lilinguyen015-sys/Capstone-Spring-2026/Documentation/ECE4773_CDR_Self_Driving_Car.pdf

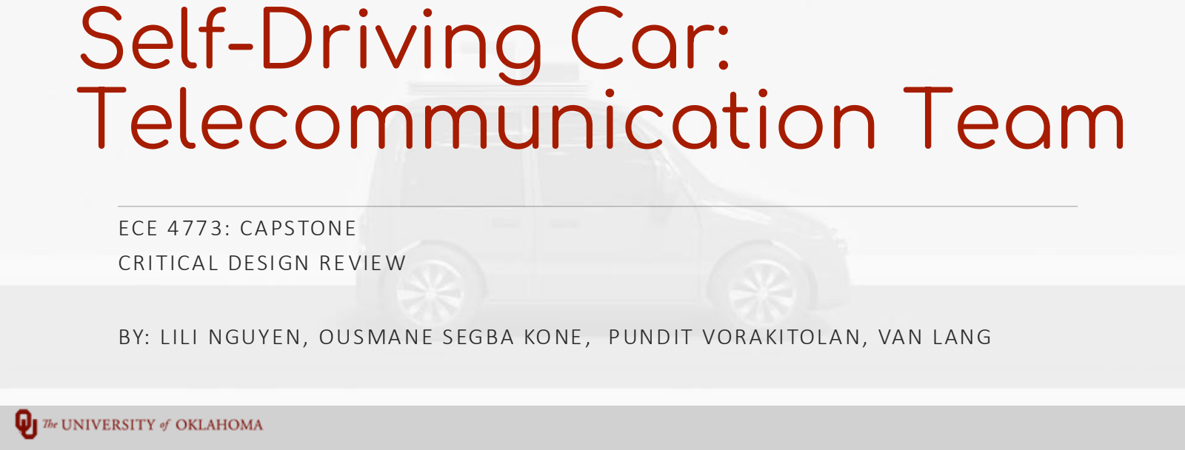
[picture p2: page 1]

# Self-Driving Car: Telecommunication Team

ECE 4 77 3: CA PS TONE
CRI TICA L DESI GN RE VIE W

BY: LILI NGUYEN, OUS MA NE S EGBA KO NE , P UND IT VORA KI TOLA N, VA N LANG

# The Problem/Requirements

- Current State:
- The 2025 Nissan Leaf is controllable via PS5 gamepad, but limited by Bluetooth range (<30 ft)
- The Challenge:
- Maintaining low-latency (≤ 100ms) over long distance networks

▪Should ensure vehicle safety if the connection drops

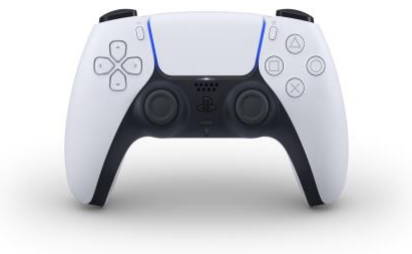
[picture p3: figure]
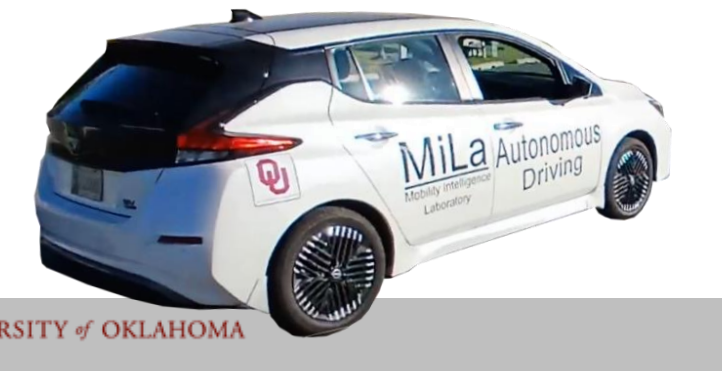
[picture p4: figure]

LN

# Design Objective

### - Read Logitech G29 input

### - Normalize steering and pedal data

### - Send commands over the communication link

### - Process commands on the ESP32Output vehicle control signals

### - Include safety and failsafe logic

LN

## Top Level Block Diagram

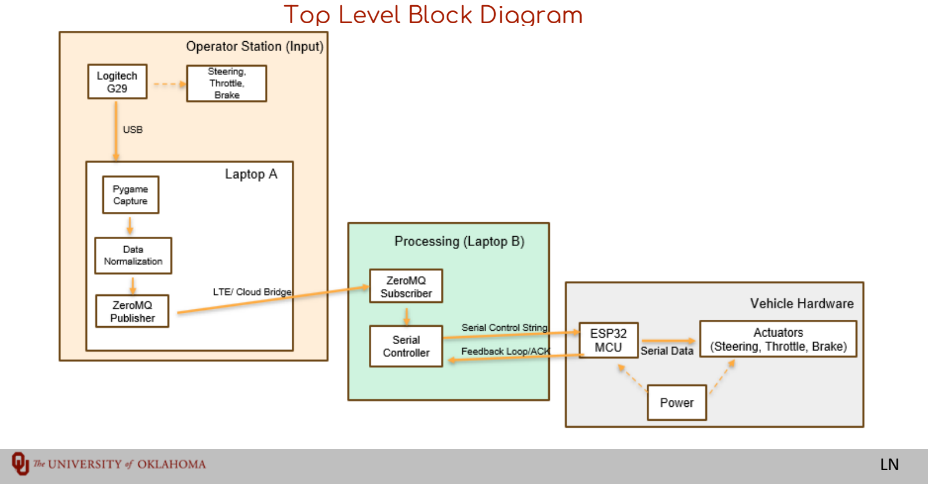
[picture p5: page 4]

LN

# Schedule/Milestones

Phase | Key Tasks | Status | Milestone / Deliverable
1. Research | Bench-test G29, Pivot to ZeroMQ | Complete | Preliminary Design
2. Development | Two-Laptop Relay Setup | Complete | Functional Communication Link
3. Integration | Bridging LTE/Cloud to the Nissan Leaf | End of March | Long-Range Connectivity Test
4. Validation | Connection Loss Drills | Early April | Safety Validation
5. Operations | Performance Audit & Final Demo | End of April | Successful Parking Lot Demo

LN

# Hardware / Software Components

OSK

### HARDWARE

- Logitech G29
- Sender Laptop
- Receiver Laptop
- ESP32
- Network Link

### SOFTWARE

- Python
- Pygame
- ZeroMQ
- JSON
- Time module

### ROLES

- Sender → Read
inputs, send events
- Receiver → Receive
events, compute
latency

# Communication / Control Flow

OSK

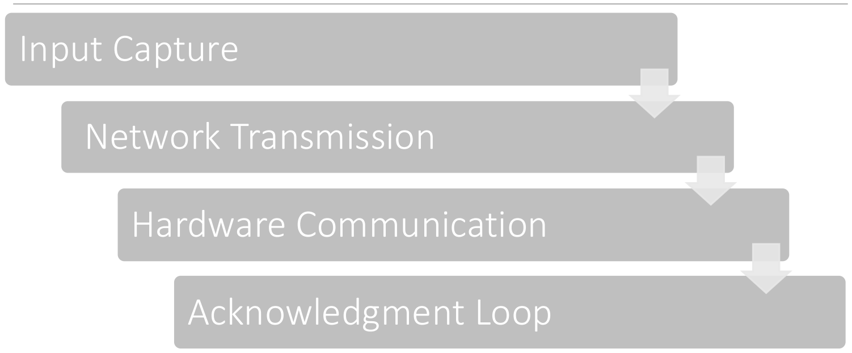
[picture p6: figure]
Input Capture; Network Transmission; Hardware Communication; Acknowledgment Loop

# Control Message Format

OSK

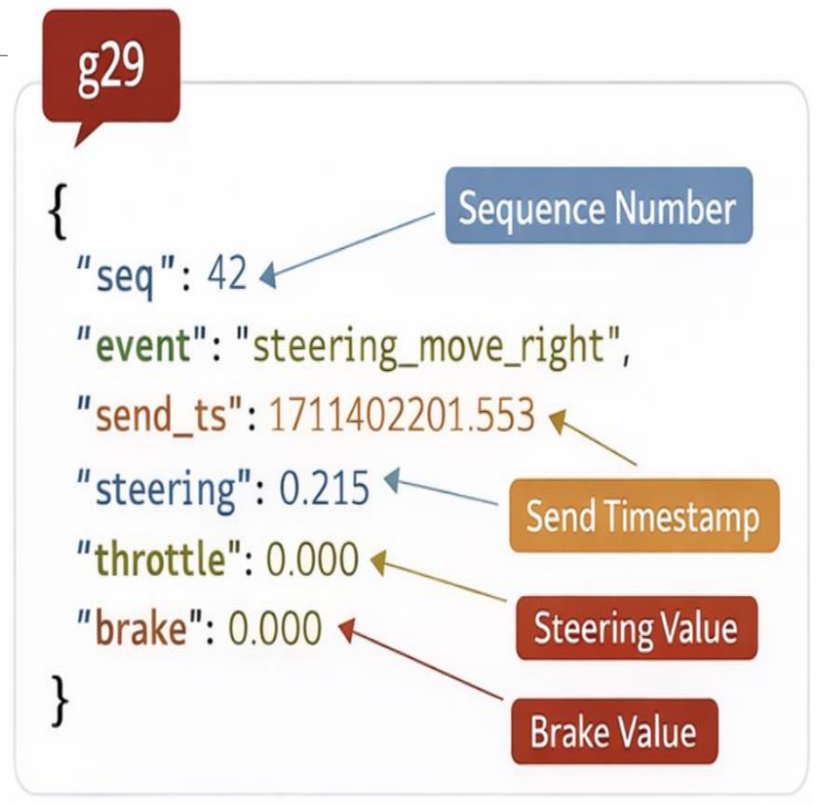
[picture p7: figure]

### - Format - G29 + JSON - Sender Laptop - Detect event - Create JSON (seq, send_ts, values) - ZeroMQ PUB send - Receiver - ZeroMQ SUB receive - Computed latency - Serial To ESP32 - ESP32 - Receive serial data - Send ACK

# Key Design Decisions

## •Looked into Bluepad32, decided to use pygame

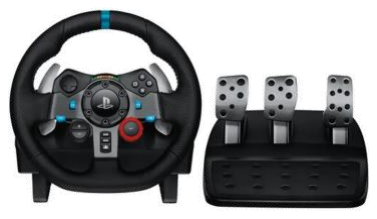
[picture p8: figure]

- Pygame is more precise for capturing data from Logitech G29 because of the 16-bit resolution input
- We want to use pygame instead of bluepad32 because we do not want to use Bluetooth

## •In our test rig, one laptop is sending data to another laptop via ESP32

### - This facilitates ease of testing/logging and adaptability to the incumbent lab car rig •ZeroMQ Pivot from MQTT

- Brokerless, ZeroMQ allows peer-to-peer connection between driver and receiver
- Reduced overhead, PUB/SUB pattern eliminates processing delay
- High frequency architecture able to support 100Hz telemetry stream, receiver gets data every 10ms

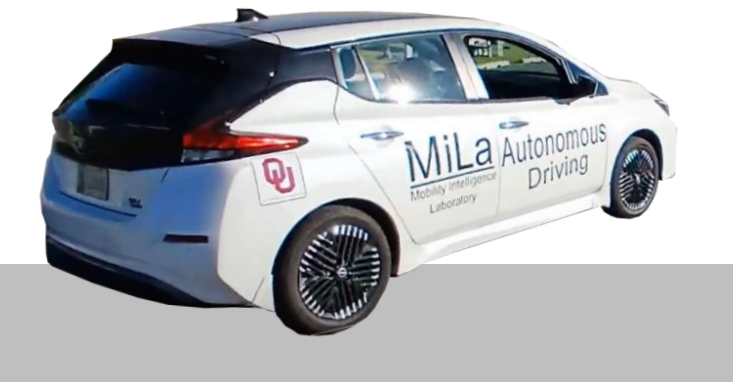
[picture p9: figure]

VL & PV

laptop
(serial)

wireless (4G LTE)

laptop
(serial)

# Integration Progress

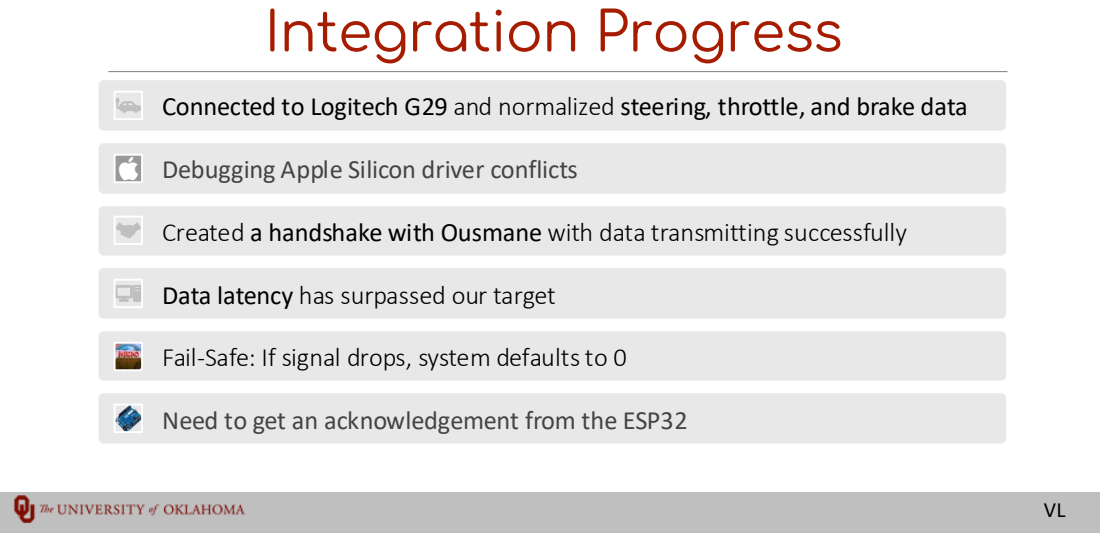
[picture p10: page 10]

Connected to Logitech G29 and normalized steering, throttle, and brake data

Debugging Apple Silicon driver conflicts

Created a handshake with Ousmane with data transmitting successfully

Data latency has surpassed our target

Fail-Safe: If signal drops, system defaults to 0

Need to get an acknowledgement from the ESP32

# Testing

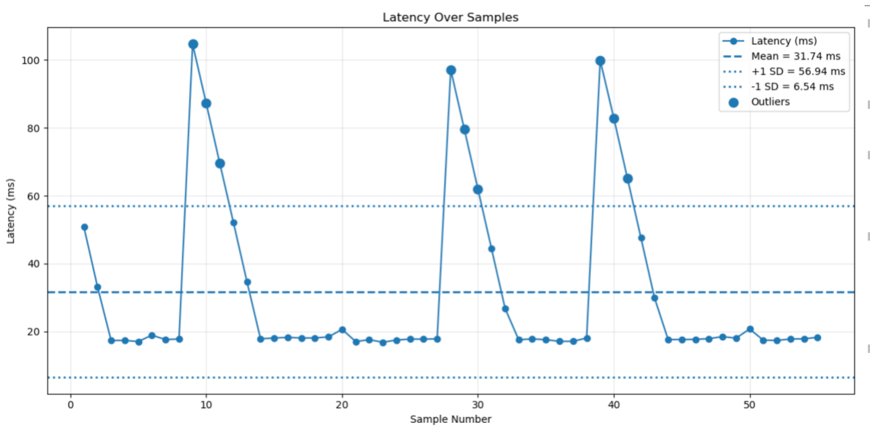
[picture p11: figure]

▪Latency between driver
workstation and receiving terminal

▪Initial target of 100ms

▪On average, ~32ms delay, well below human reaction time

▪Loop runs at 100Hz (10ms
intervals)- prevents packet buffering

▪Measured from differing
distances

VL

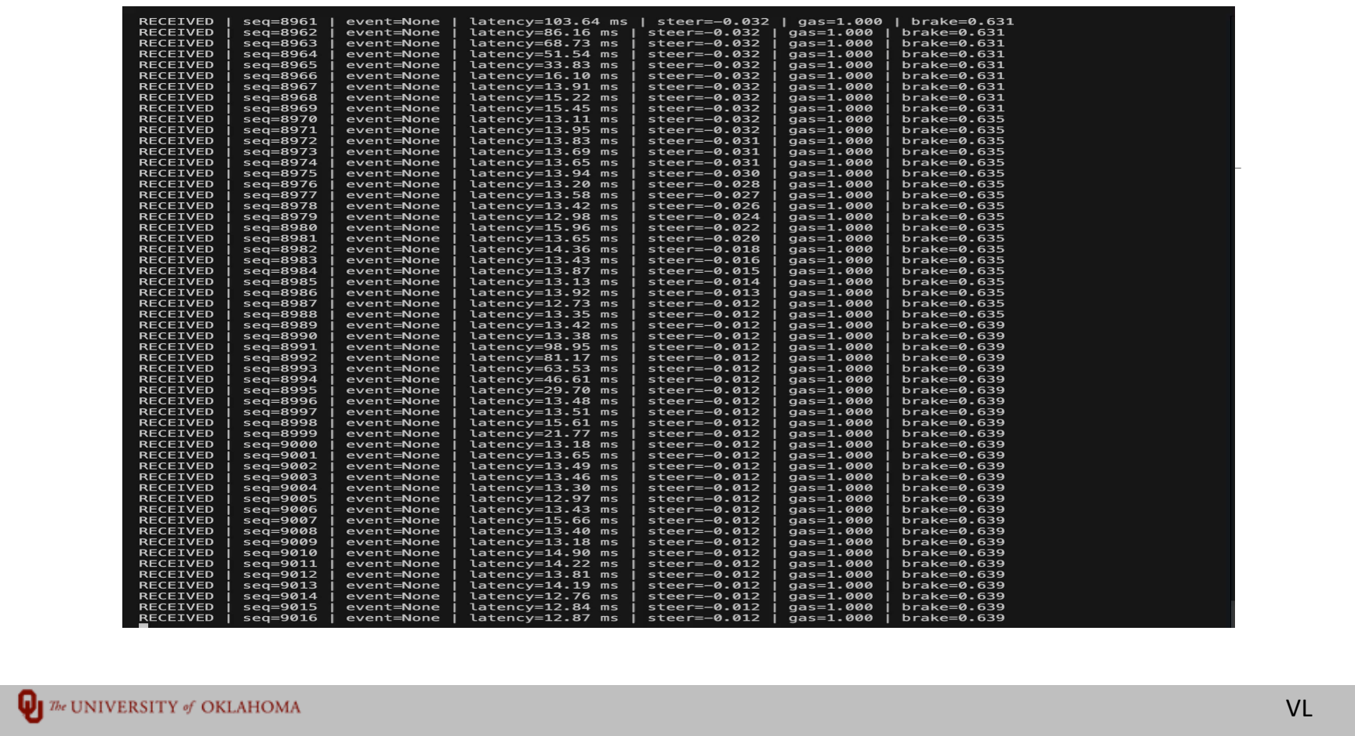
[picture p12: page 12]

VL

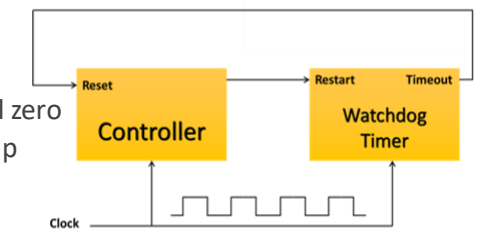
[picture p13: figure]

# Safety

PV

### - Communication loss

- Watchdog timer will trigger an automatic stop/values transmitted will zero
- Sustained latency (250ms for more than 2-3 seconds) will trigger a stop
- Reminder: current packet rate is an arbitrary 100 Hz

### - Connectivity recommendations

- We suggest upgrading to 5G and looking towards Starlink in the future
- Currently, 4G LTE averages 30-50ms latency and 5G averages 10-30ms; 4G LTE works well, but a higher rate of jitter poses a safety concern
- Starlink is currently too unreliable (too much variability) for sustained use, although in real life testing it is useful as a safety backup (tradeoff is cost)
- Keep an eye out for the Starlink v3 constellation and 5G DTC (direct to cell)

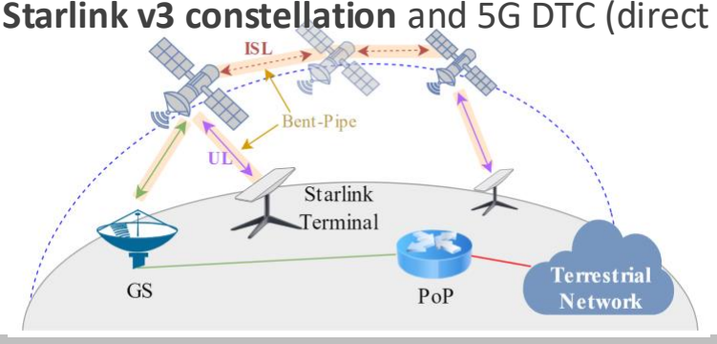
[picture p14: figure]

# Budget/BoM

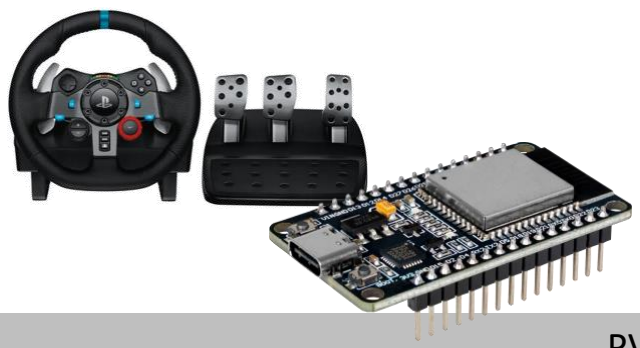
[picture p15: figure]

PV

Item | Cost | In Lab Inventory?
Driving Simulator | ~$300 | Yes
ESP32 x2 | ~$15 | Yes
Wires + Cables | Nominal (~$20) | Yes

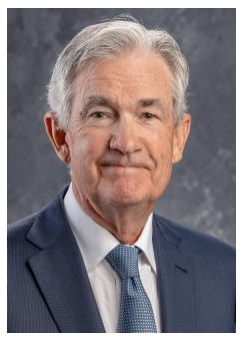
[picture p16: figure]

# Looking Ahead

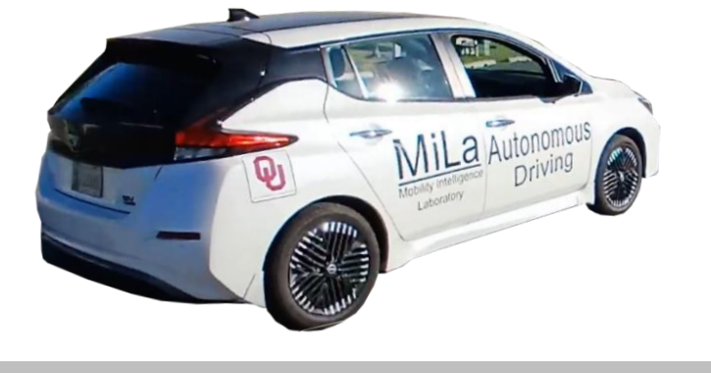
[picture p17: figure]

PV

## - Take and implement recommendations/action items

- Any other safety recommendations? We feel like the #1 safety concern are spikes in latency

## - Connect system to car and test in real life

- We need to get a better idea how our system performs outside of our test setting
- Currently we are benchmarking using wifi, not 4G LTE.... our numbers will likely get worse
- Controlling the car via CAN bus will also add latency
- Do we need to implement methods (stripping back packet complexity, adopting leaner software packages) that will nominally but noticeably reduce latency?

## - Set groundwork for handoff

- Build uptime/latency/current state GUI dashboard (software
package works with macOS or Windows
- Record a ground truth dataset (i.e. timestamped G29 inputs vs actual vehicle response)

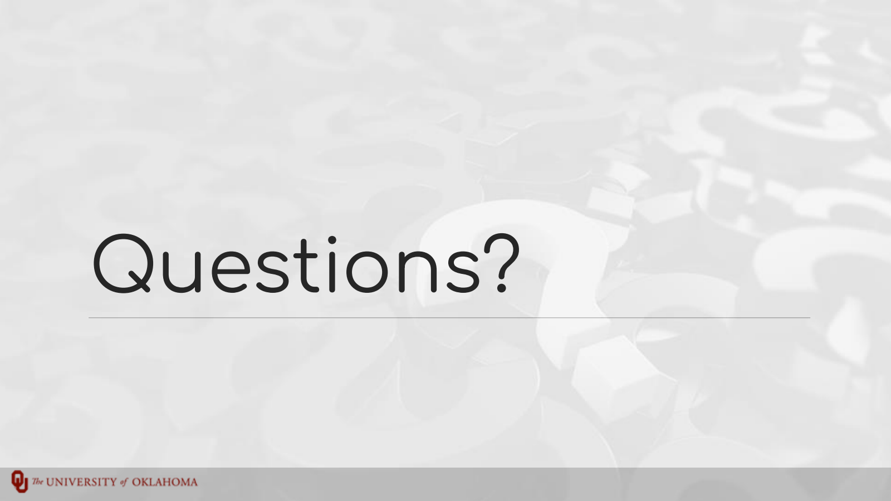
[picture p18: page 16]

# Questions?

# Backup Slides

# Driving Sim Software Block Diagram

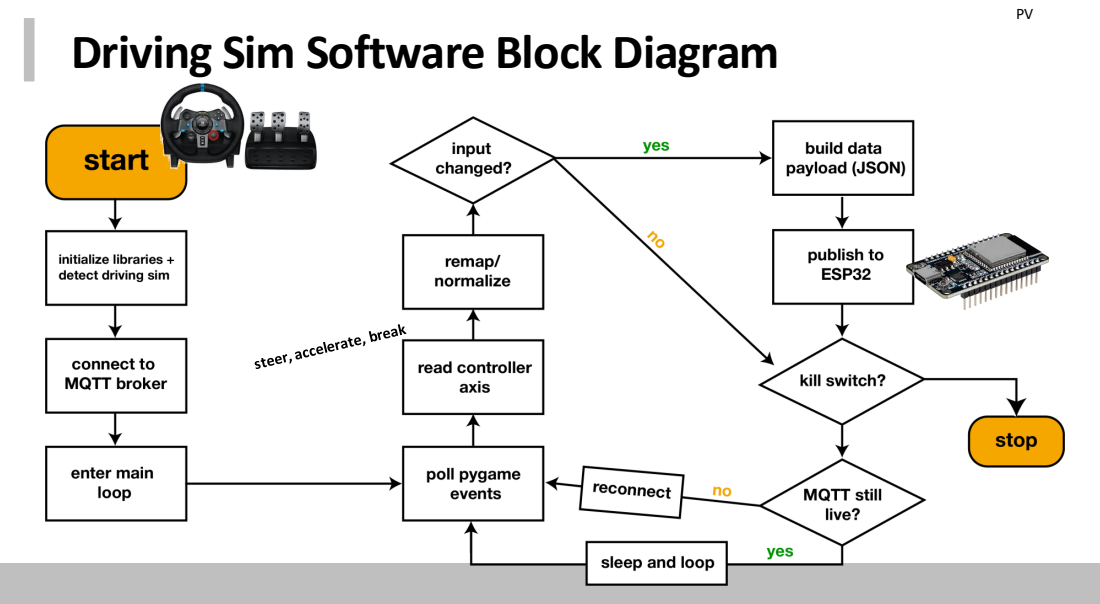
[picture p19: page 19]

# ESP32 Software Block Diagram

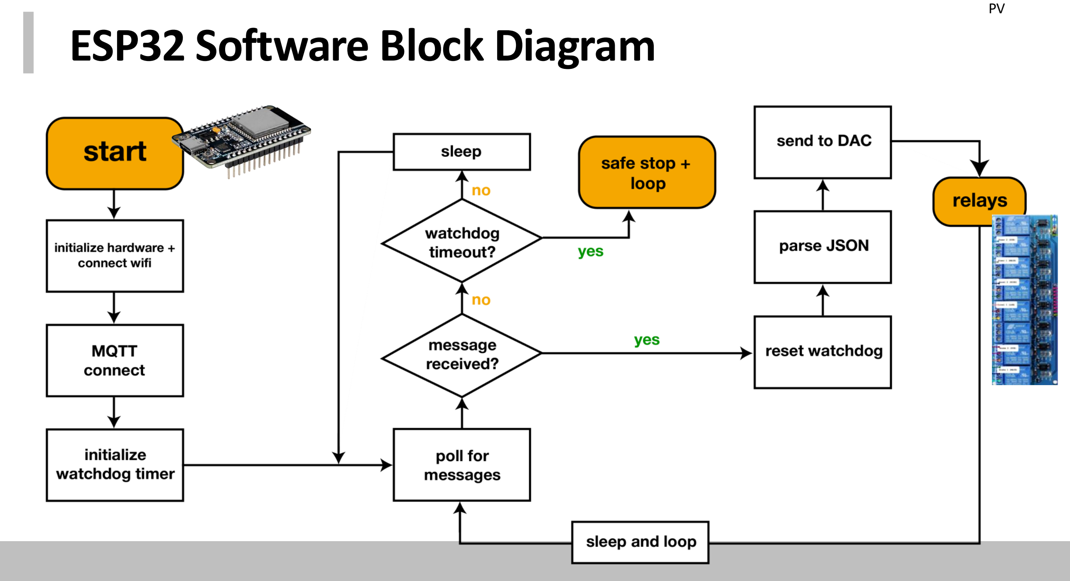
[picture p20: page 20]

PV

## Major Tradeoff Issues Simplicity -> Complexity ZeroMQ vs other protocols

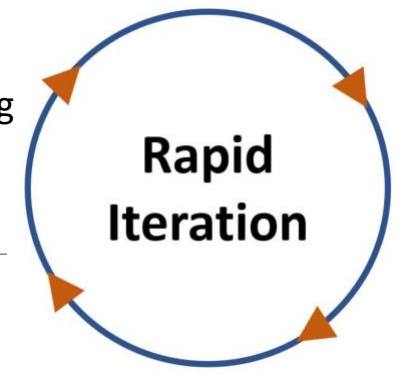
[picture p21: figure]

## - Other protocols/methods of remotely communication may reduce latency - Better to start simple and add complexity later G29 vs PS5 controller - The G29 is more reliable and provides a closer simulation to real life - Instead of Bluetooth, we can use a more customizable communication protocol

working
system

upgrade
