lilinguyen015-sys/Capstone-Spring-2026/Documentation/ECE4773_PDR_Self_Driving_Car.pdf

# Teleoperation:

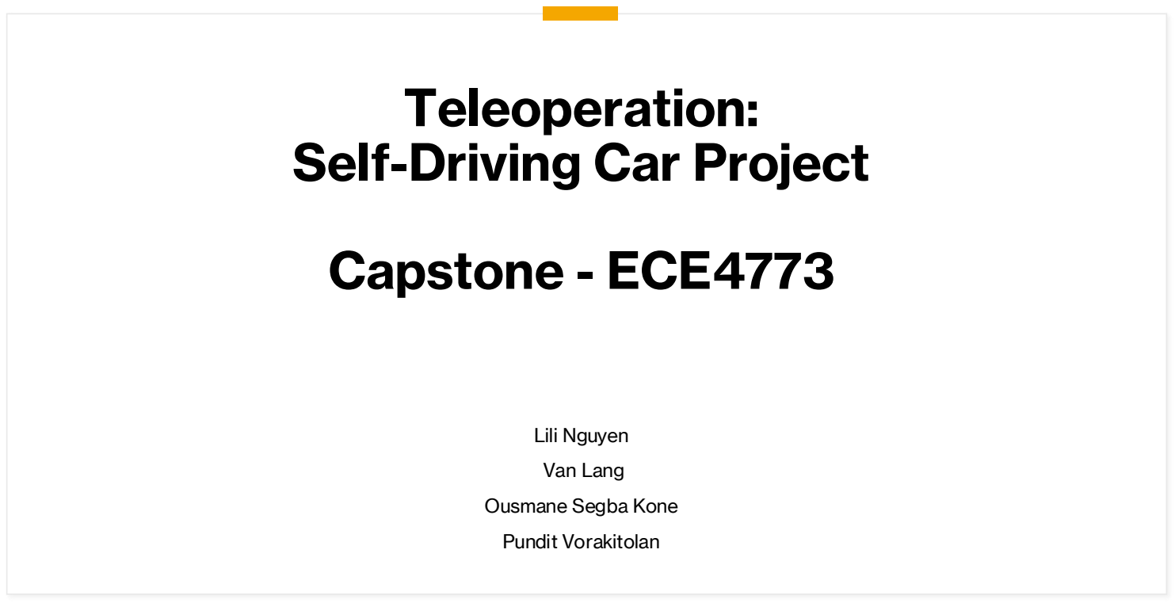
[picture p22: page 1]

# Self-Driving Car Project

# Capstone - ECE4773

Lili Nguyen

Van Lang

Ousmane Segba Kone

Pundit Vorakitolan

## Lili Nguyen (PM)

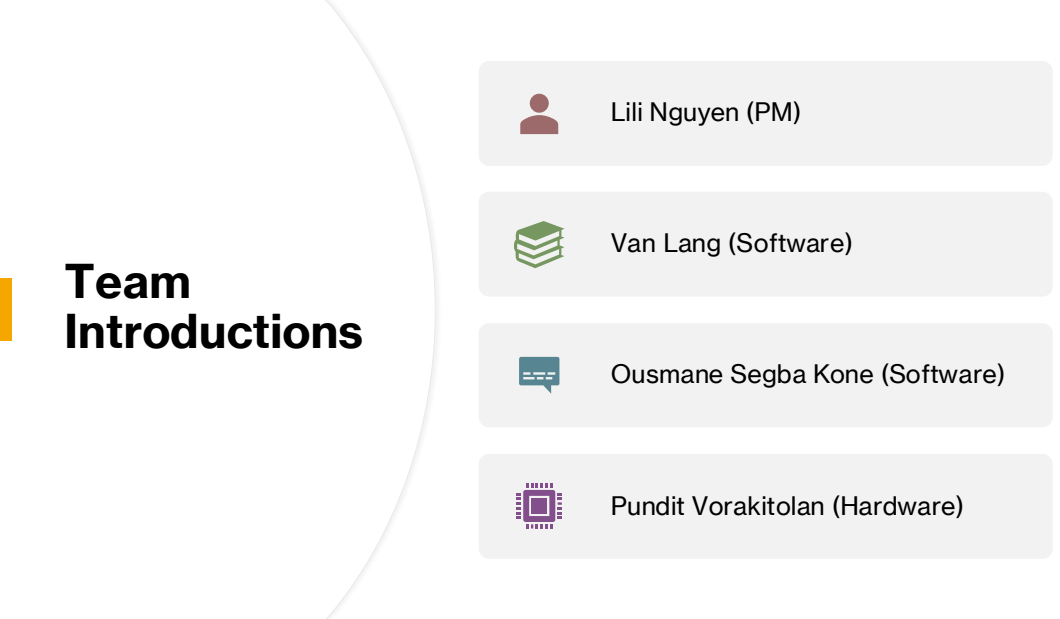
[picture p23: page 2]
Team Introductions

Van Lang (Software)

Ousmane Segba Kone (Software)

Pundit Vorakitolan (Hardware)

# MiLab Introduction

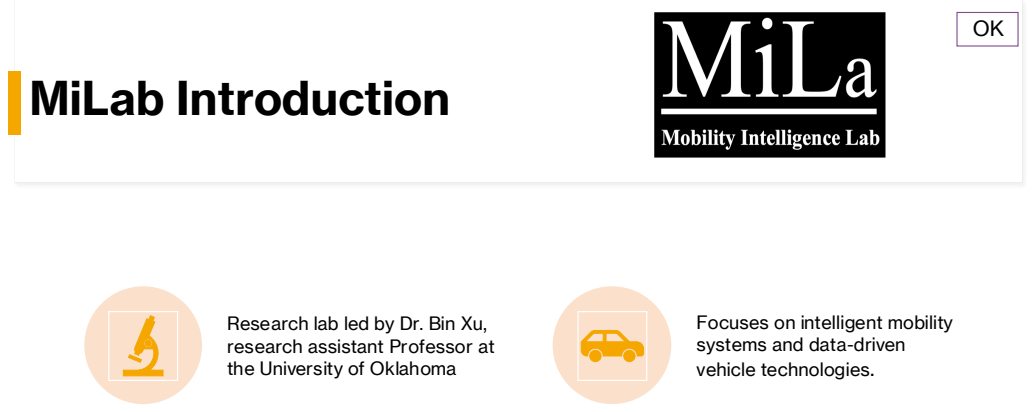
[picture p24: page 3]

Research lab led by Dr. Bin Xu,
research assistant Professor at
the University of Oklahoma

Focuses on intelligent mobility
systems and data-driven
vehicle technologies.

# Problem Statement: MiLab lacks a reliable long-distance communication system to remotely control a DBW-enabled

car using a driving simulator.

OK

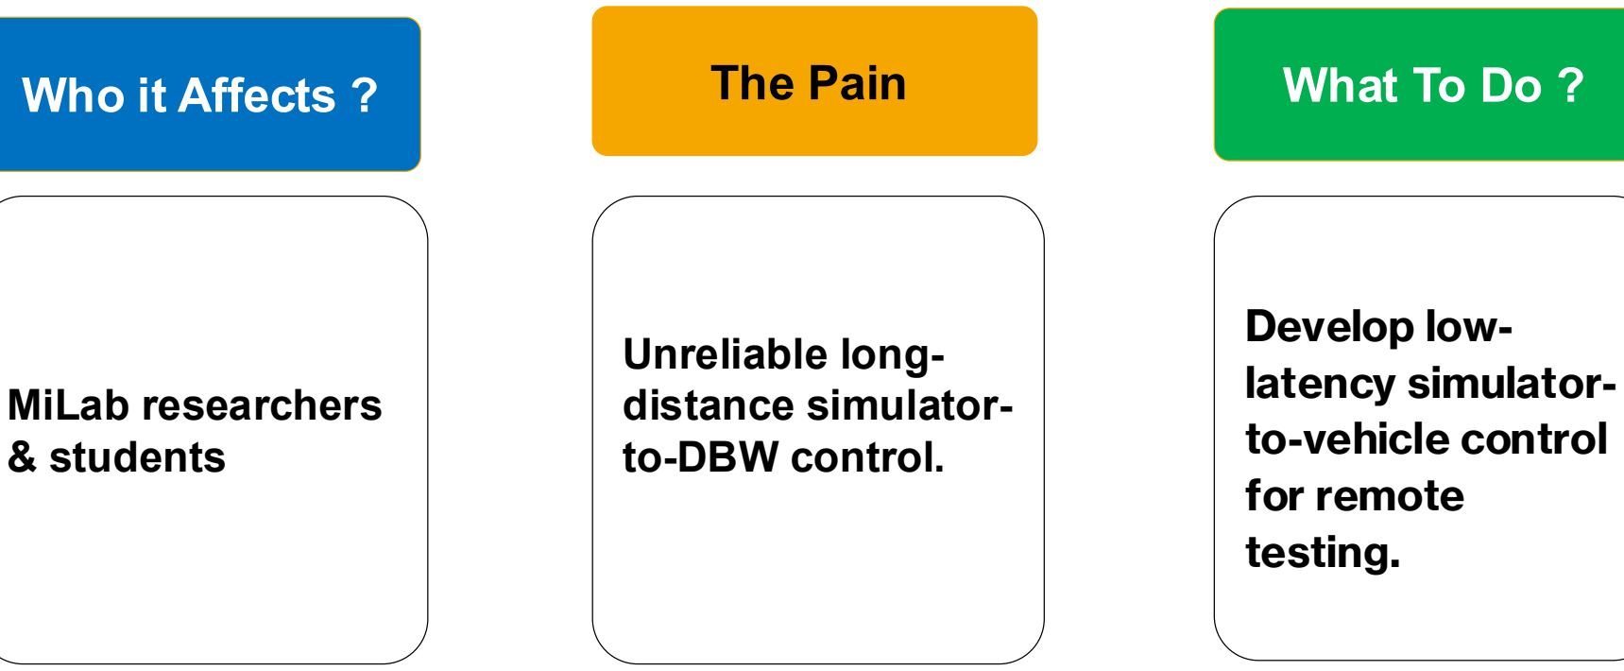
[picture p25: figure]
Develop low- latency simulator- to-vehicle control for remote testing.; Unreliable long- distance simulator- to-DBW control.; MiLab researchers & students; Who it Affects ?; The Pain; What To Do ?
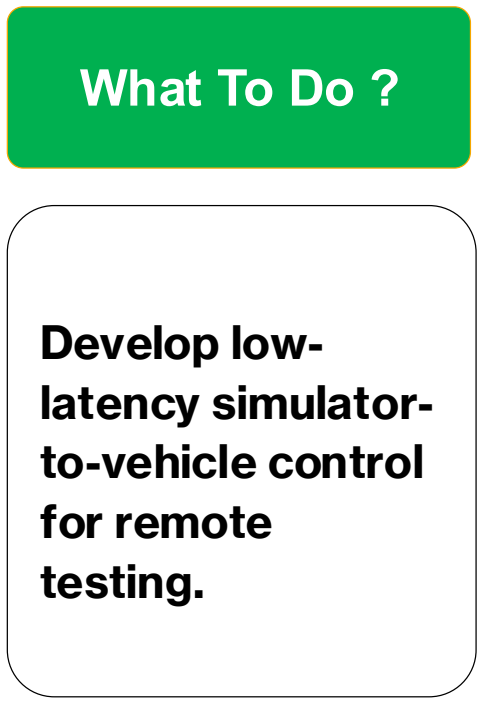
[picture p26: figure]
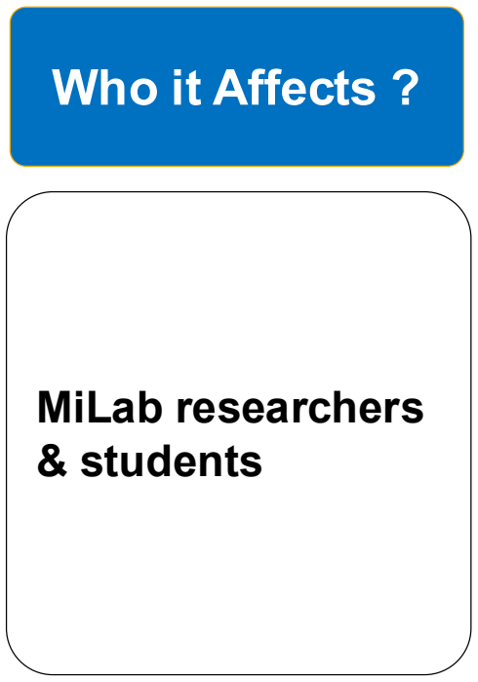
[picture p27: figure]

# System Overview

OK

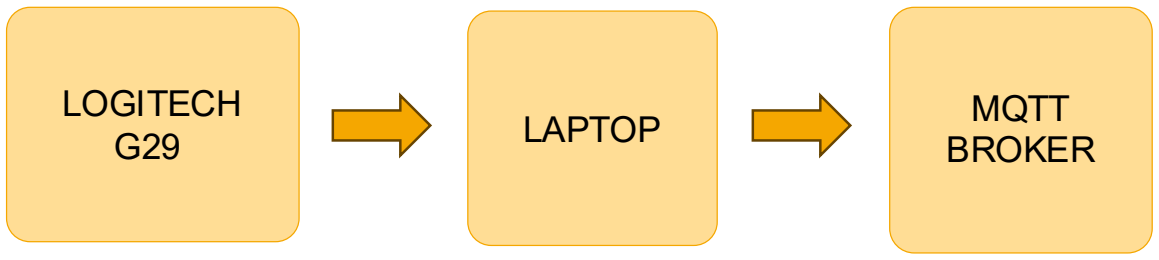
[picture p28: figure]
MQTT; BROKER LAPTOP LOGITECH G29

STEERING
BRAKING
ACCELERATING
ON VEHICLE

ESP32 ON
VEHICLE

# Quantitative Design Requirements

### - Input Precision for Bluepad32

- Requirement: The system must map 16 bit analog inputs from the Logitech G29
- Metric: 256 discrete steps for the throttle/brake and steering (0 to 255)

### - Data Throughput

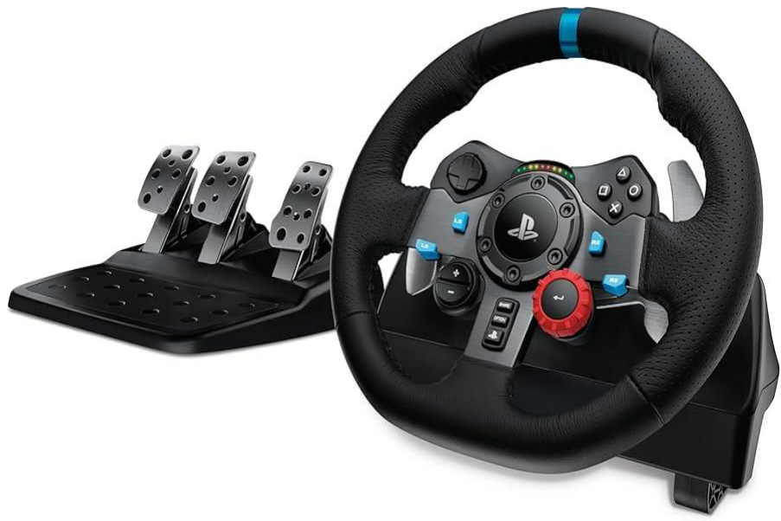
[picture p29: figure]

- Requirement: Maintain consistent telemetry stream
- Metric: Update frequency at 100Hz to ensure smooth control loops

VL

# Performance Objectives

### - Latency

- Objective: minimize the latency from the driving simulator
- Target: Latency < 200ms

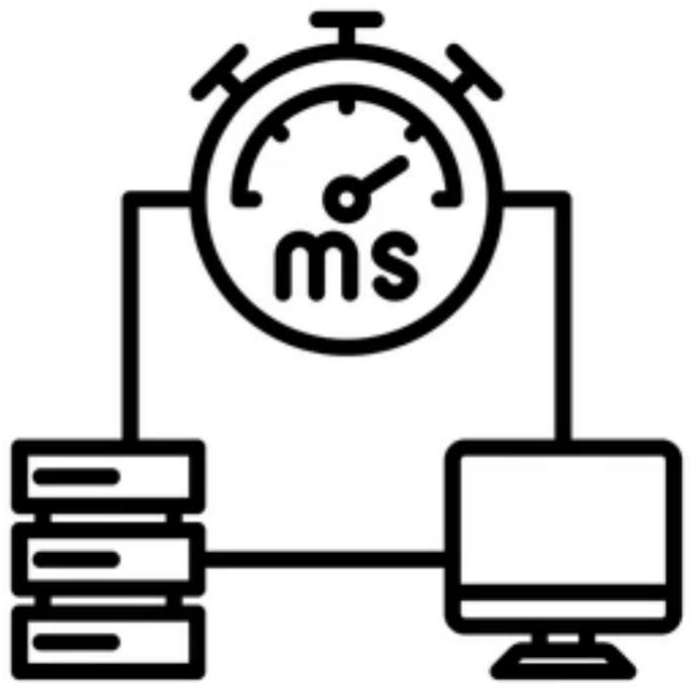
[picture p30: figure]

### - Connection Stability

- Objective: Maintain connection without drops
- Target: Successful packet rates during the driving session

VL

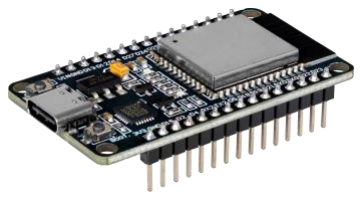
[picture p31: figure]
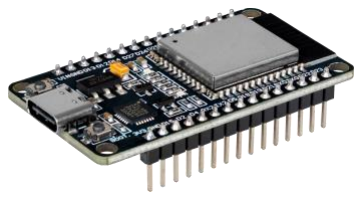
[picture p32: figure]

# Source Code

## - Bluepad32 uses a virtual gamepad

## - Uni_gamepad.h

### - Data structure for steering, throttle, and braking

## - Uni_controller.h

### - Manages bluetooth and connection handshakes

## - Take these principles from Bluetooth and apply them to our system

VL

# Technical Approach

### - Get a working MVP, then rapidly iterate on it

- MVP will likely be similar to the other two capstone teams
- We all have the same hardware so no Bill of Materials
- Ultimate goal is to reduce latency; we want to test as many differing ideas as possible
- Allows for course correction and evolving to help the lab where it needs it the most

### - MVP approach

- Interface between a Logitech G29 and an ESP32 using python
- Use the lab’s incumbent protocol (MQTT) to transmit messages via intermediary (broker)
- Once messages arrive at the car ESP32/relay/DAC PCB board, hand-off to DBW team

### - Improving the MVP

- Send telemetry/feedback data from the car
- Timestamp and track down/fix root cause of latency

PV

Focus: use software to wirelessly interface between a driving simulator and a car. Iterate on that MVP, optimize latency, and control the car well enough to drift.

serial

wireless

# Technical Approach

### - We have a DBW (drive-by-wire) system to integrate our system into

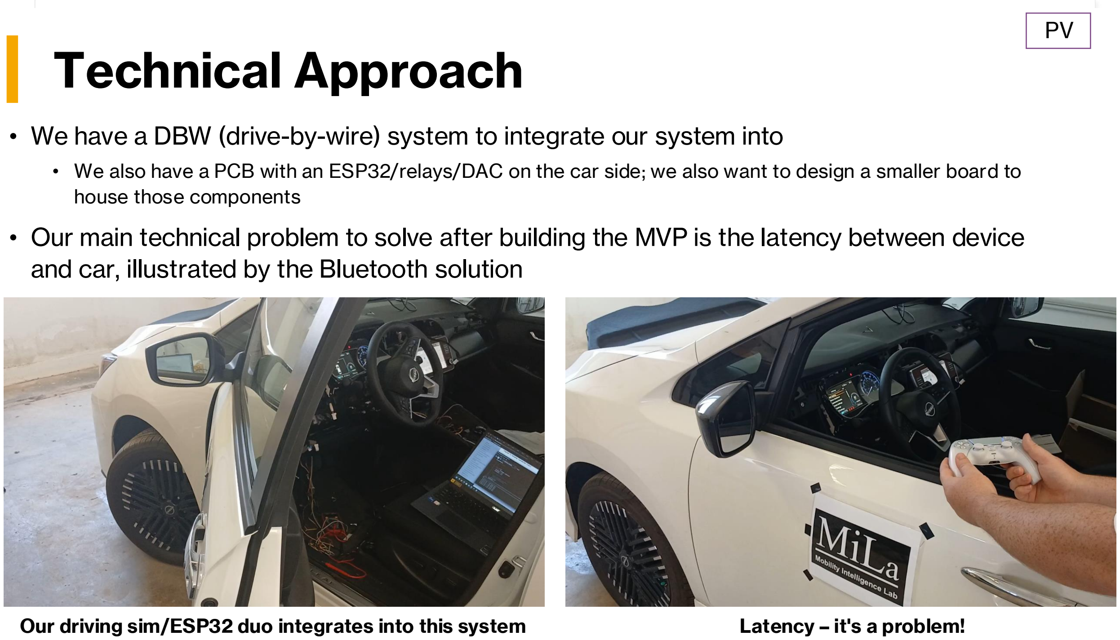
[picture p33: page 10]

- We also have a PCB with an ESP32/relays/DAC on the car side; we also want to design a smaller board to house those components
- Our main technical problem to solve after building the MVP is the latency between device

### and car, illustrated by the Bluetooth solution

PV

Our driving sim/ESP32 duo integrates into this system | Latency – it's a problem!

# Latency & Upgrades

PV

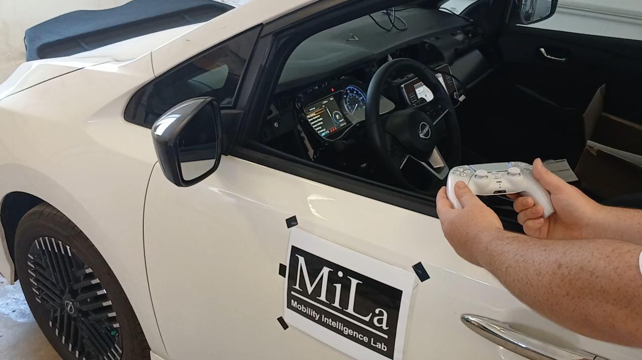
[picture p34: figure]
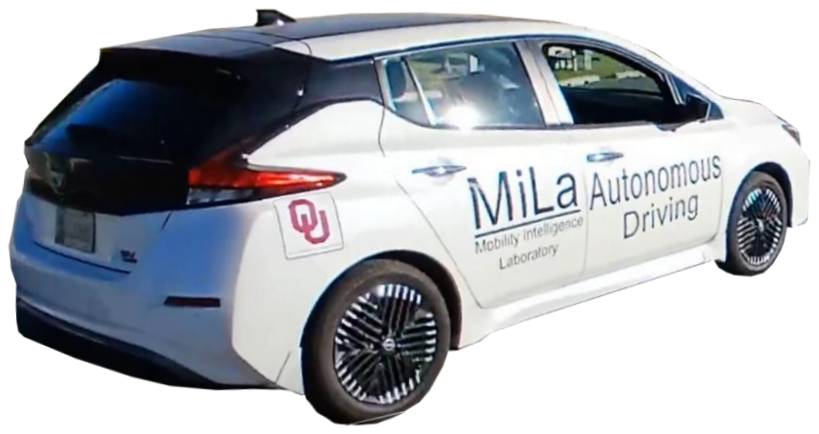
[picture p35: figure]

Latency – it's a problem!

### - A PS5 controller over bluepad32 should only add a few milliseconds

- Our 1-2 sec latency comes from another source
- We should look at timestamp logging to identify the issue
- Adding another network layer will only exacerbate the problem
- Slow ESP32/car ECU processing likely suspect?

### - Start with pygame and upgrade to psydl2 when we need to optimize latency

### - Add features like force feedback on the wheel

# Driving Sim Software Block Diagram

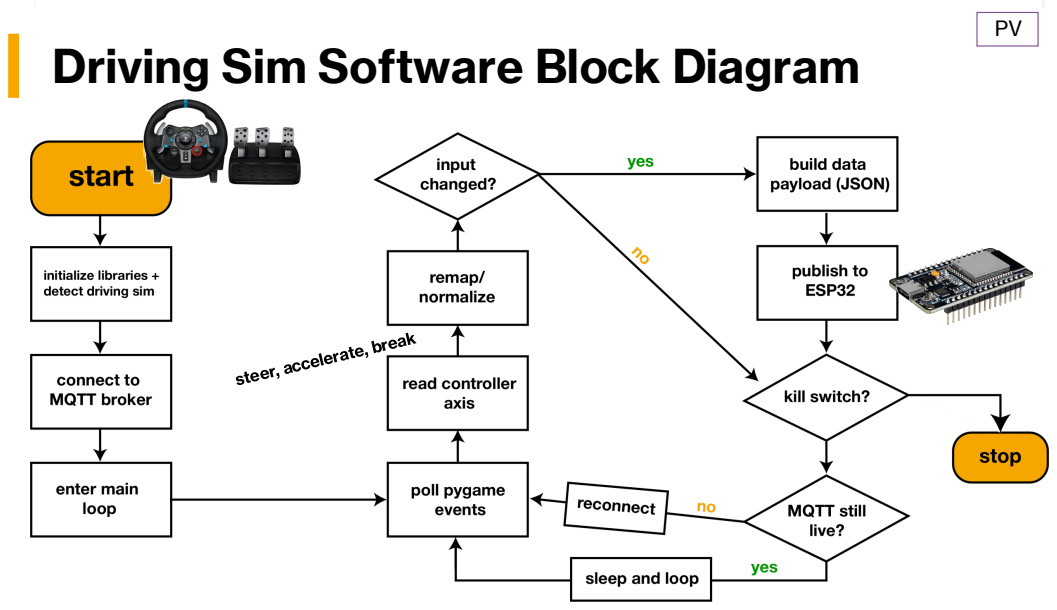
[picture p36: page 12]

# ESP32 Software Block Diagram

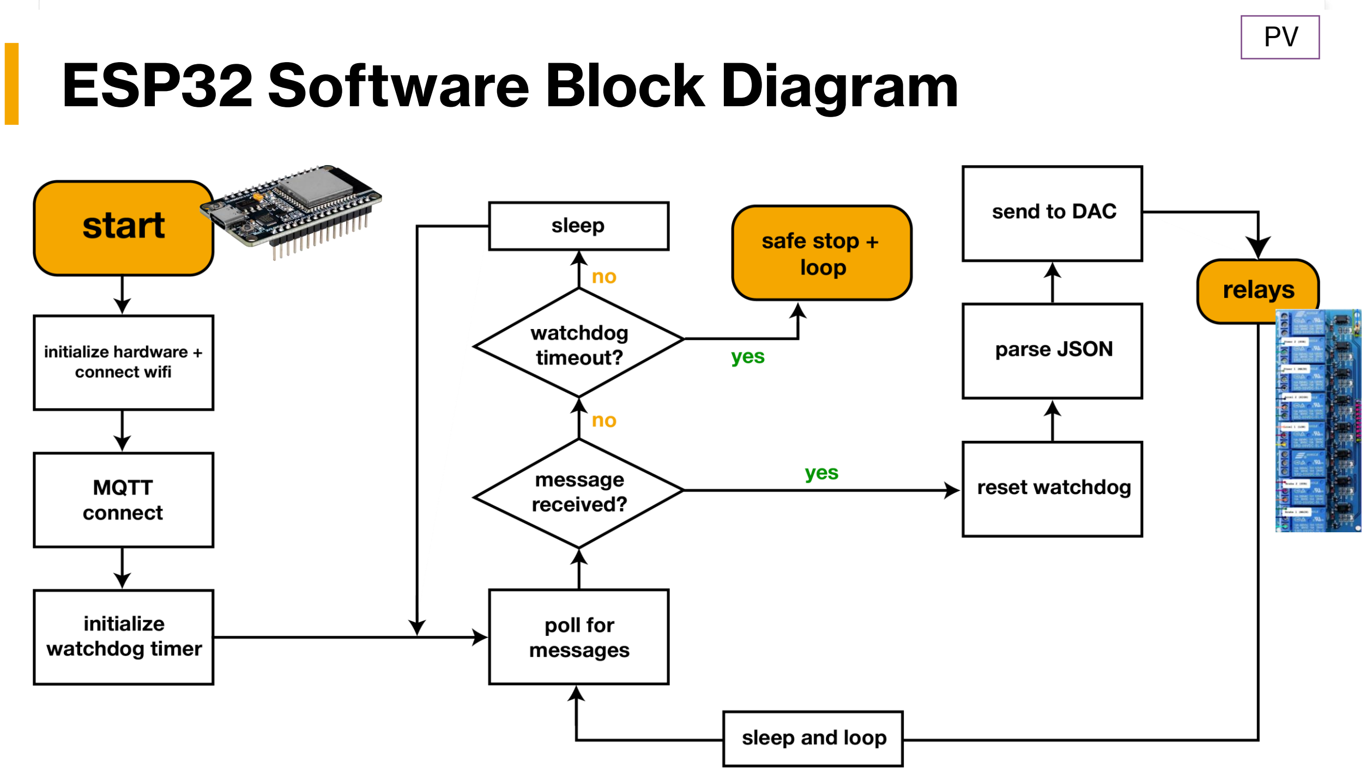
[picture p37: page 13]

PV

# ESP32 Software Block Diagram

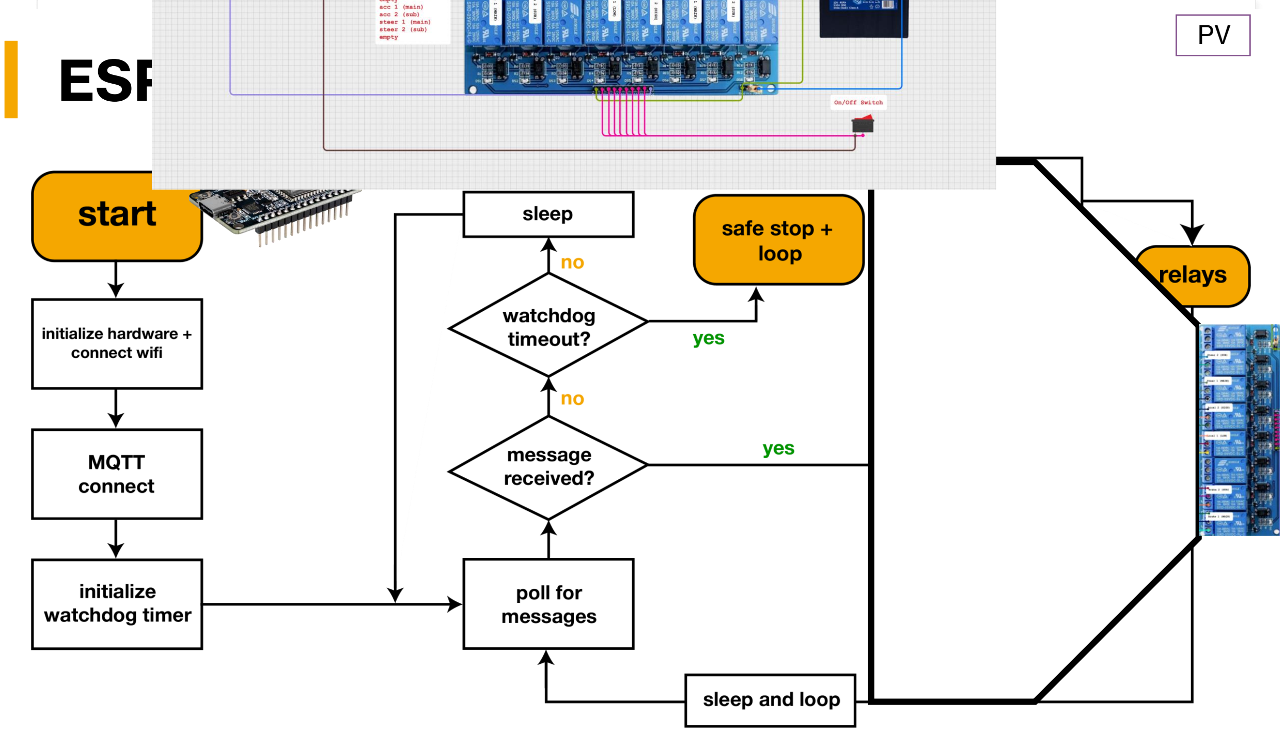
[picture p38: page 14]

PV

# Safety Considerations

## - Controlled Testing

## - Hard Stop

## - Operator Awareness

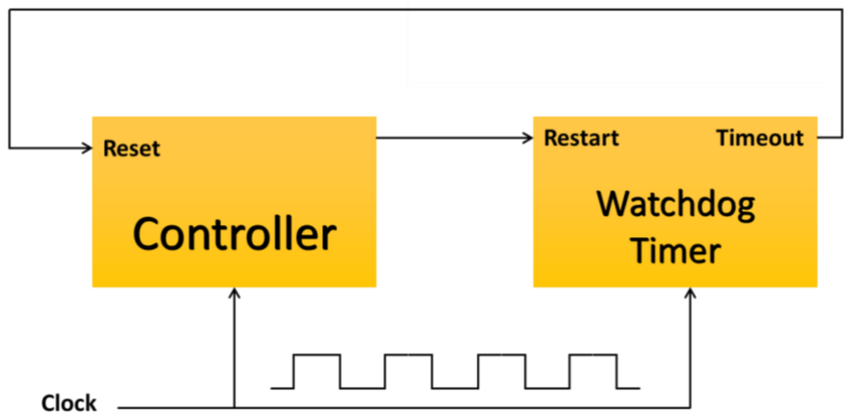
[picture p39: figure]

## - Comms Loss Behavior

LN

# Major Tradeoff Issues

## - Simplicity -> Complexity

## - MQTT vs other protocols

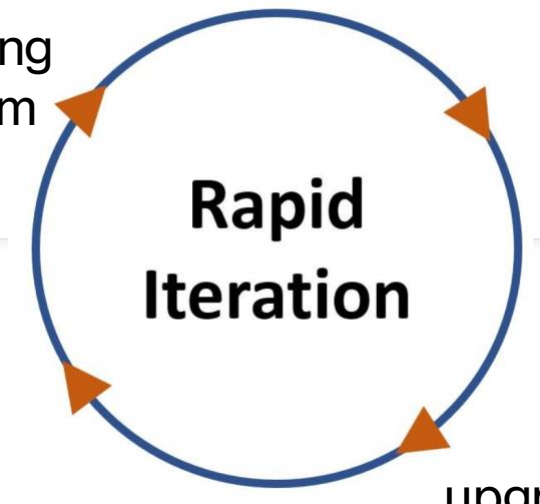
[picture p40: figure]

### - Other protocols/methods of remotely communication may reduce latency - MQTT is actively being used by this lab - Better to start simple and add complexity later

## - G29 vs PS5 controller

### - The G29 is more reliable and provides a closer simulation to real life - Instead of Bluetooth, we can use a more customizable communication protocol

LN

working
system

upgrade

# Cost/Budget

## - Main costs are small parts:

### - ESP32 boards - wires, connectors, adapters - power parts (regulator, fuse, switch)

## - Cost control

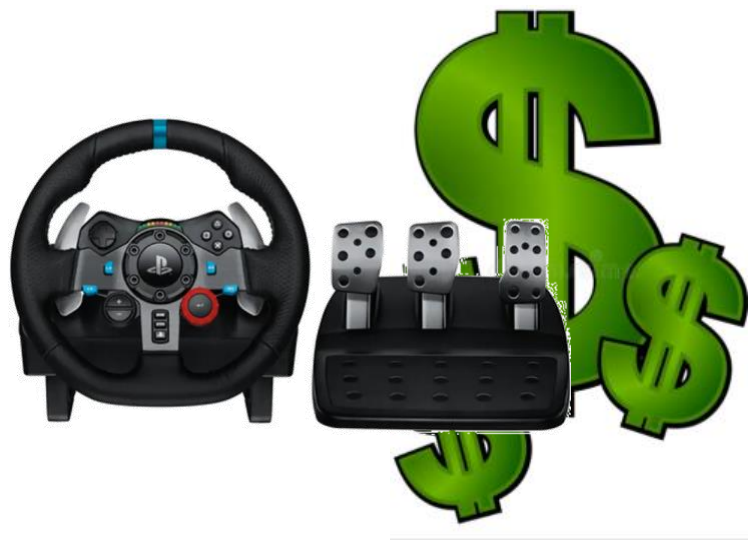
[picture p41: figure]

### - Use lab’s existing DBW system, share the same expensive hardware with other teams

## - Budget risk: extra parts if hardware breaks

## - Plan: pre-test early to avoid damage and reduce rework

LN

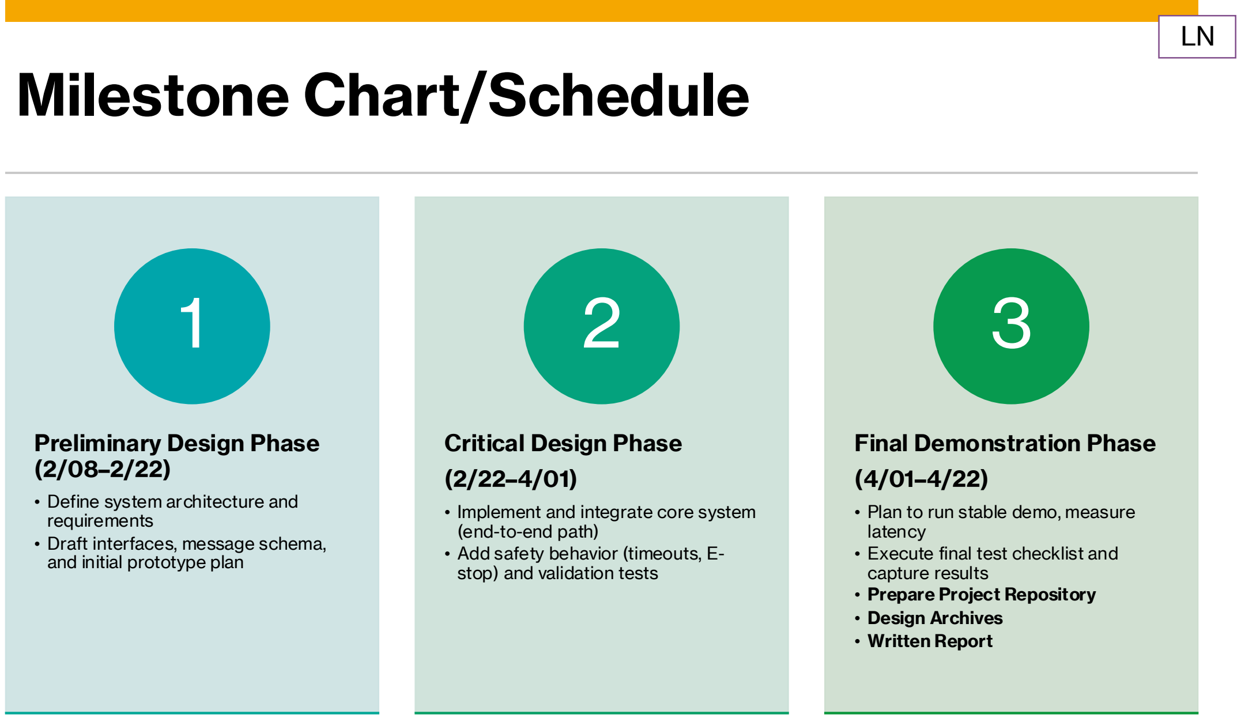
[picture p42: figure]
Milestone Chart/Schedule; Preliminary Design Phase (2/08–2/22); • Define system architecture and requirements • Draft interfaces, message schema, and initial prototype plan; Critical Design Phase; • Implement and integrate core system (end-to-end path) • Add safety behavior (timeouts, E- stop) and validation tests; Final Demonstration Phase; • Plan to run stable demo, measure latency • Execute final test checklist and capture results • Prepare Project Repository • Design Archives • Written Report
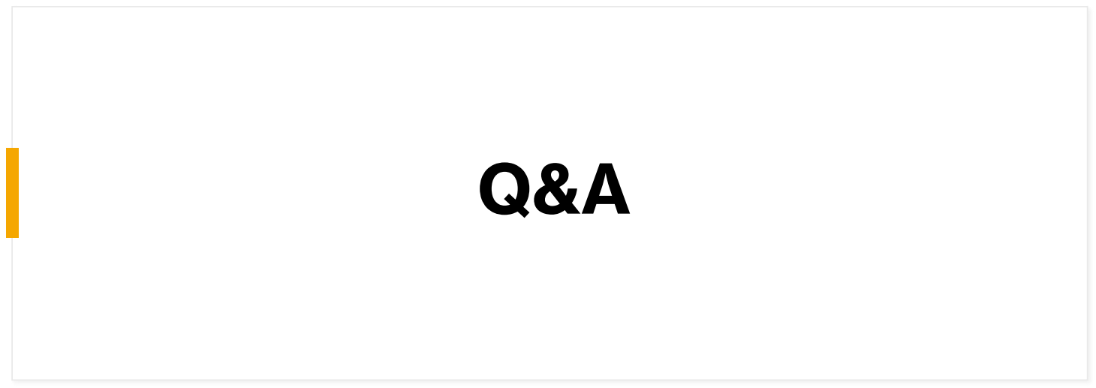
[picture p43: page 19]

Q&A
