lilinguyen015-sys/Capstone-Spring-2026/Documentation/BOM_Wireless_DBW.xlsx

Supplier | Part Number | Description | Quantity | Unit Cost | Total Cost | Notes
Amazon | B08D5ZD528 | Logitech G29 Driving Force Racing Wheel + Pedals | 1 | $249.99 |  | ★ Purchased — budget item
Amazon | B09GK74F7N | ESP32-WROOM-32 DevKit V1 Development Board | 1 | $9.99
JLCPCB | N/A | Custom 2-Layer DBW PCB (5-board minimum order) | 1 | $18.00
Digi-Key | MCP2515-I/P-ND | MCP2515 CAN Bus Controller w/ SPI Interface (DIP-18) | 1 | $1.82
Digi-Key | MCP4728A0T-E/UN-ND | MCP4728 Quad 12-Bit I2C DAC | 2 | $2.63
Amazon | B07GHT9TF7 | 8 MHz Crystal Oscillator (for MCP2515) | 1 | $5.99
Amazon | B07J7NB75Z | Mobile WiFi Hotspot (or use smartphone as hotspot) | 1 | $49.99
Oracle Cloud | N/A | OCI VM.Standard.E2.1.Micro Compute Instance (Always Free) | 1 | $0.00
Amazon | B07V6JMFCM | OBD2 CAN Bus Twisted Pair Cable (16AWG, 6ft) | 1 | $9.99
Amazon | B08FD39Y5R | Assorted Dupont Jumper Wires + Pin Headers Kit | 1 | $7.99
Used Car Market | N/A | Nissan Leaf (used, model year 2015–2018) | 1 | $8500.00
 |  |  |  | Grand Total
Budget note: all components except the Logitech G29 were already on hand. Our out-of-pocket budget consisted solely of the G29 driving simulator, shared amongst the other capstone teams.
