lilinguyen015-sys/Capstone-Spring-2026/(commit log)

2026-04-29 esp32 commands
2026-04-30 add OBS multi-camera note and fix packet format in readme
2026-05-01 add bill of materials excel spreadsheet
    [BOM_Wireless_DBW.xlsx]
2026-05-01 add nissan leaf to BOM
    [BOM_Wireless_DBW.xlsx]
2026-05-01 add user manual and design document; pep8 python files; update BOM
    [BOM_Wireless_DBW.xlsx]
2026-05-01 Fix audit inaccuracies; simplify README; clean up BOM notes
    - design_doc.tex: correct DAC baseline counts to match float32 truncation
    in firmware (steer 2473->2469, accel1 370->369, accel2 750->749,
    brake1 3417->3419; brake2 1509 unchanged)
    - README.md: rewrite as concise reference — add repo URL, keep only
    System Overview, Hardware Requirements (component table), Software
    Requirements, Setup, and Running the System; fix seq=00001->seq=00000
    - BOM: remove OCI footnote row, strip asterisk from OCI description,
    update budget note to reflect G29 as sole out-of-pocket purchase
    shared amongst capstone teams
    - Recompile design_doc.pdf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
    [BOM_Wireless_DBW.xlsx]
